klaute/AmbiController/README.md

AmbiController - The FPGA based Autonomous Light Controller
===========================================================

Or just another ambilight clone?

See [AmbiController](http://klautesblog.blogspot.de/search/label/AmbiController)
