klaute/AmbiController/doc/ambilight_v0.4.1_bottom.pdf

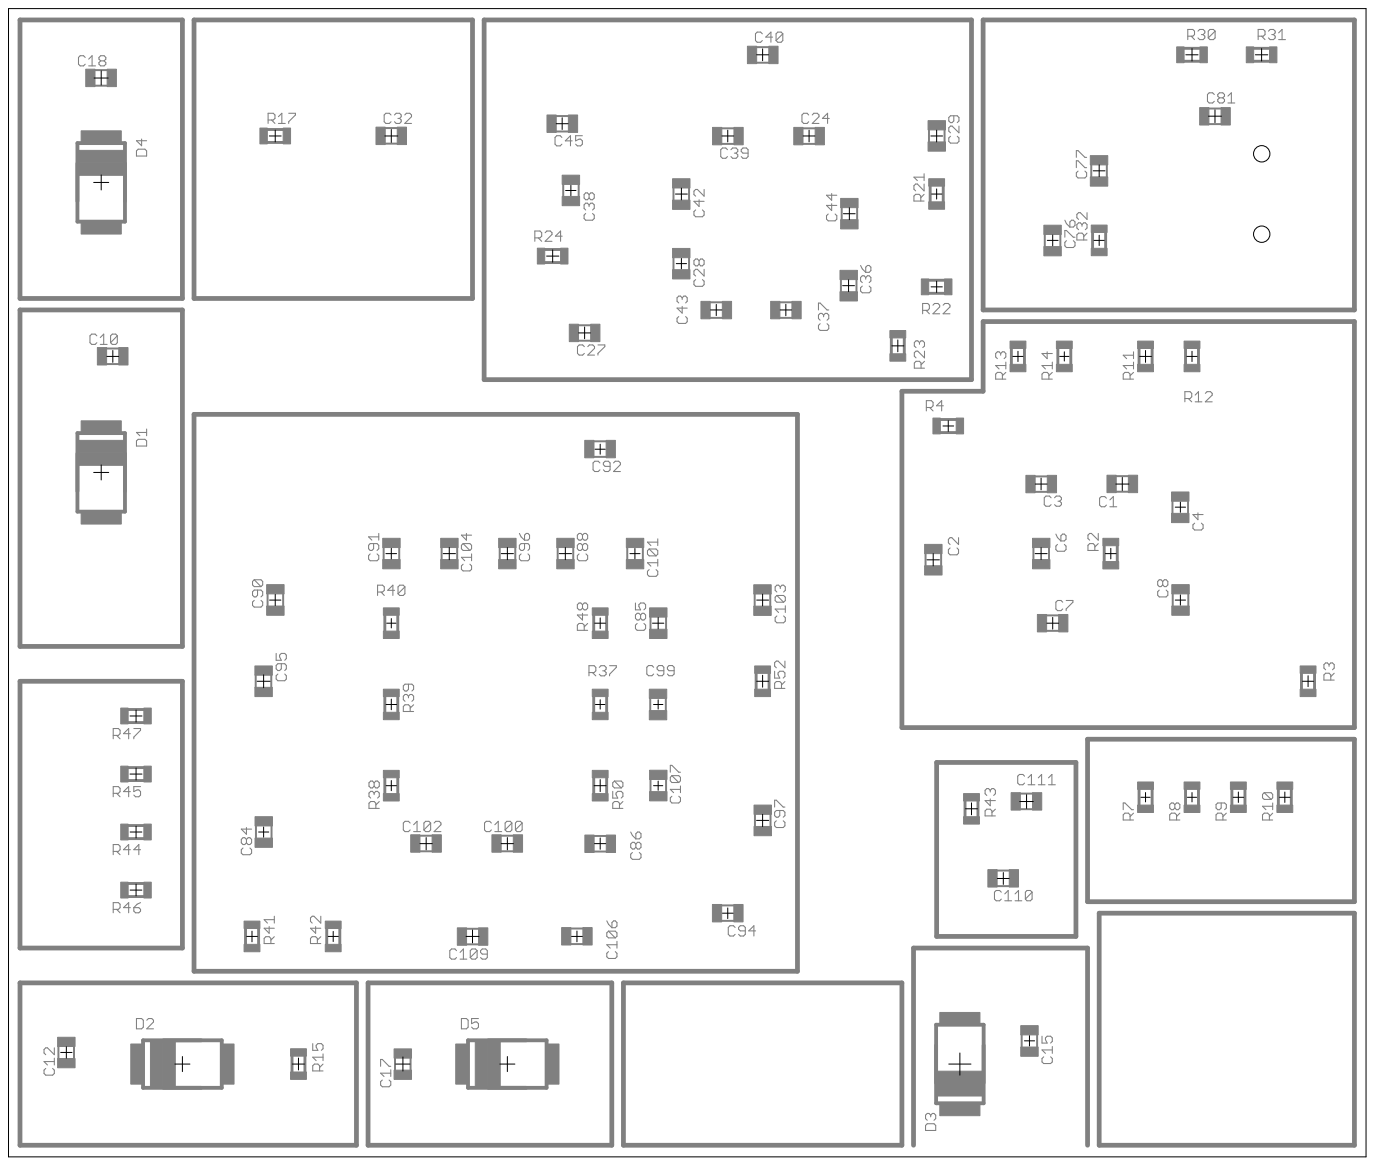
[picture p9: page 1]
