klaute/AmbiController/doc/ambilight_v0.4.1_top.pdf

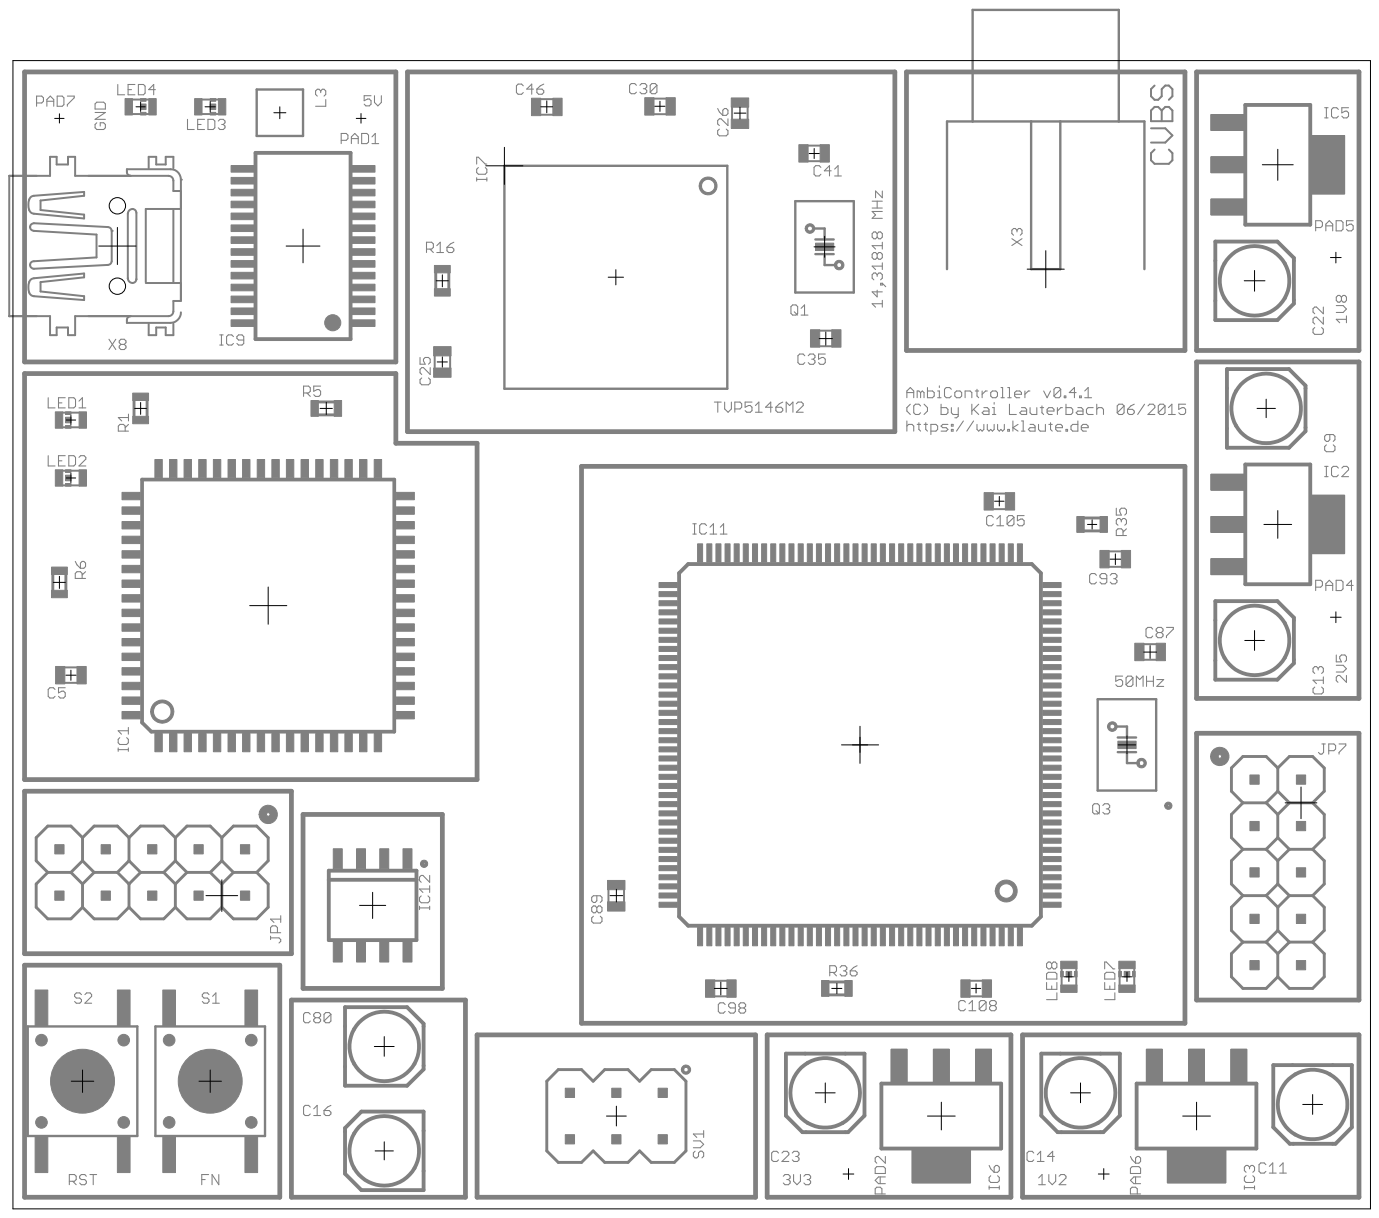
[picture p10: page 1]
