klaute/AmbiController/tools/bctool/bc_message_defs.h

#define BC_READER_FIRST_START_CHAR        '<'  // 0x3c
#define BC_READER_SECOND_START_CHAR       '>'  // 0x3e
#define BC_READER_FIRST_END_CHAR          '\r' // 0x13
#define BC_READER_SECOND_END_CHAR         '\n' // 0x10
#define BC_ANSWER_OK                      'K' // 
#define BC_ANSWER_NOK                     'N' // 
