klaute/AmbiController/tools/bctool/bc_message_types.h

#define BC_OUT_MSG_TYPE_ANSWER            'A' //< Outgoing message is a answer to an incoming message
#define BC_OUT_MSG_TYPE_STATUS            'S' //< Outgoing message is a status because there was an error.
#define BC_OUT_MSG_TYPE_YCBCR_FRAME_DATA 'Y' //< Outgoing message is a part of the received video data.
#define BC_OUT_MSG_TYPE_RGB_LED_DATA     'R' //< Outgoing message is a part of the processed LED data.
