klaute/AmbiController/tools/bctool/gui_help.c

/**!\brief WARNING!!! Do not change this function!!! It will be rebuild automatically during bctool's make process.
 *
 */
void showGUIHelp()
{

        printf("\nBCTool GUI HotKey's:\n");
        printf("====================\n");
        printf("    a - read the ADV status\n");
        printf("    b - Reset the AVR for firmware update\n");
        printf("    c - clear the display\n");
        printf("    d - switch to ADV as video input\n");
        printf("    e - disable ambilight processing\n");
        printf("    f - read the ambilight status\n");
        printf("    i - set the loglevel to 253 (send RGB and YCbCr pixel data)\n");
        printf("    l - set the loglevel to 252 (send RGB pixel data)\n");
        printf("    m - set the FPGA data simulation flag\n");
        printf("    n - Skip to the next TVP video input channel.\n");
        printf("    o - set the loglevel to 255 (send YCbCr pixel data)\n");
        printf("    p - set the loglevel to 254 (normal mode, no pixel data will be send)\n");
        printf("    q - Exit the FrameView executable.\n");
        printf("    r - Reset the AVR\n");
        printf("    s - Set switch to TVP as video input\n");
        printf("    t - read the TVP status\n");
        printf("    w - enable ambilight processing\n");

}
