klaute/AmbiController/tools/bctool/gui_helper.h

/*
 * (C) 2014 by Kai Lauterbach (lauterbach.kai@web.de)
 *
 * License: General Public License (GPL v3)
 *
 */

/*****************************************************************************/

void gui_init_window(void);

void gui_show_YCbCr_pixel(unsigned int, unsigned int, unsigned int, unsigned int, unsigned int);

void gui_show_RGB_pixel(unsigned int, unsigned int, unsigned int, unsigned int);

void gui_clear_display(void);

void gui_pixel_test(void);

void gui_pollSDLWindowFunctionality(void);

/*****************************************************************************/
