klaute/AmbiController/(commit log)

2013-07-26 AVR XMega board added.
    [avr_board.sch]
2013-08-24 DSP schematic added.
    [avr_board.sch, dsp_board.sch]
2013-09-03 DSP schematic readded after merge conflict.
    [dsp_board.sch]
2015-04-15 Old schematics and board file removed.
    [avr_board.sch, dsp_board.sch]
2015-04-15 Initial commit of the content for the v0.4 coming hardware releaase.
    [BTM222-config.txt]
2015-04-19 First win64 tools added to release forlder. BCTool prepared for dynamic LED strip sizes.
2015-04-24 SDL functionality removed from BCTool. Channel Config Tool prepared to generate inverted config files.
    [fileaccess.pde, globals.h]
2015-05-03 Framerate increased. Default EEPROM content fixed.
2015-05-22 New firmware release added. TFC-Mode is stil broken. Binary mode enabled for the USB connection. Tools updated/recompiled.
    [bc_commands.h, bc_message_defs.h, bctool.c, bin_comm_func.c, bin_comm_func.h]
2015-07-25 Outdated documentation files removed.
    [BTM222-config.txt]
2015-08-26 Some bugfixes and optimizations done in the commandline tools. Window bctool update is comeing next.
    [bctool.c, bin_comm_func.c, fpga_flash.h, globals.h, serial_helper.c, serial_helper.h]
2015-08-26 BCTool updated, some new code added to prevent unusual timeouts in BCTool. Cygwin DLL updated.
    [bin_comm_func.c, globals.h]
